AmirMohammad-Nouri/edge-ai-stress-sense/tools/ml/models/benchmark.md

# LOSO benchmark on WESAD wrist (BVP + EDA + ACC, no TEMP)

Accuracy / macro-F1 in %, leave-one-subject-out over 15 subjects.

## binary - raw features

| features | DT acc | DT F1 | RF acc | RF F1 | AB acc | AB F1 | LDA acc | LDA F1 | kNN acc | kNN F1 |
|---|---|---|---|---|---|---|---|---|---|---|
| bvp | 85.5 | 83.6 | 88.4 | 86.9 | 88.0 | 86.4 | 90.2 | 88.4 | 88.9 | 87.1 |
| eda | 78.8 | 75.0 | 80.5 | 77.1 | 78.6 | 75.1 | 85.4 | 82.4 | 84.7 | 82.3 |
| acc | 83.6 | 80.9 | 87.5 | 85.0 | 87.1 | 84.8 | 80.6 | 72.1 | 79.1 | 75.1 |
| physio | 84.0 | 82.1 | 86.5 | 85.0 | 87.6 | 85.9 | 91.2 | 89.6 | 90.1 | 88.6 |
| all | 85.9 | 84.4 | 86.8 | 85.3 | 90.2 | 88.7 | 94.3 | 93.3 | 91.9 | 90.6 |

## binary - relative to personal baseline

| features | DT acc | DT F1 | RF acc | RF F1 | AB acc | AB F1 | LDA acc | LDA F1 | kNN acc | kNN F1 |
|---|---|---|---|---|---|---|---|---|---|---|
| bvp | 84.3 | 81.6 | 87.6 | 85.4 | 87.9 | 85.8 | 87.8 | 85.1 | 85.8 | 82.9 |
| eda | 79.0 | 76.0 | 86.2 | 83.5 | 82.2 | 79.1 | 88.9 | 86.1 | 83.9 | 81.0 |
| acc | 81.0 | 77.6 | 81.9 | 76.4 | 81.7 | 77.9 | 77.7 | 71.5 | 77.0 | 69.9 |
| physio | 90.4 | 89.0 | 93.6 | 92.7 | 94.7 | 93.8 | 91.3 | 89.3 | 93.1 | 91.7 |
| all | 91.8 | 90.6 | 93.3 | 92.4 | 94.9 | 94.1 | 94.4 | 93.2 | 93.9 | 92.6 |

## 3class - raw features

| features | DT acc | DT F1 | RF acc | RF F1 | AB acc | AB F1 | LDA acc | LDA F1 | kNN acc | kNN F1 |
|---|---|---|---|---|---|---|---|---|---|---|
| bvp | 62.0 | 54.5 | 68.6 | 56.9 | 67.1 | 58.1 | 74.8 | 56.7 | 69.3 | 58.1 |
| eda | 56.2 | 46.2 | 60.8 | 49.5 | 59.2 | 49.9 | 70.3 | 50.9 | 66.7 | 56.6 |
| acc | 65.1 | 57.7 | 74.9 | 67.0 | 71.8 | 65.6 | 67.8 | 53.8 | 64.0 | 55.3 |
| physio | 59.5 | 54.1 | 67.1 | 57.0 | 63.8 | 58.3 | 74.6 | 57.3 | 69.5 | 59.1 |
| all | 69.1 | 64.0 | 72.3 | 65.0 | 70.4 | 65.2 | 77.3 | 66.7 | 74.7 | 65.9 |

## 3class - relative to personal baseline

| features | DT acc | DT F1 | RF acc | RF F1 | AB acc | AB F1 | LDA acc | LDA F1 | kNN acc | kNN F1 |
|---|---|---|---|---|---|---|---|---|---|---|
| bvp | 63.0 | 55.7 | 71.0 | 58.9 | 66.0 | 56.7 | 73.0 | 54.0 | 69.4 | 56.3 |
| eda | 62.1 | 53.0 | 74.0 | 62.4 | 69.3 | 57.8 | 72.5 | 53.9 | 66.6 | 56.4 |
| acc | 57.6 | 49.9 | 66.4 | 53.4 | 65.2 | 57.7 | 64.6 | 53.0 | 58.7 | 49.6 |
| physio | 69.0 | 61.5 | 77.5 | 64.2 | 74.8 | 65.4 | 75.5 | 58.3 | 75.3 | 62.0 |
| all | 71.5 | 63.9 | 77.3 | 63.2 | 76.1 | 69.9 | 77.6 | 66.9 | 76.7 | 65.5 |

Paper reference (wrist physio = BVP+EDA+TEMP, Table 3/4): binary RF 88.3 % acc / 86.1 % F1; 3-class AB 73.6 % / RF 76.2 % acc.
