AmirMohammad-Nouri/edge-ai-stress-sense/esp8266_vitals/src/secrets.example.h

#pragma once
// Normally generated from .env by `python3 tools/make_secrets.py`.
// Alternative: copy this file to esp8266_vitals/src/secrets.h and edit it by hand.
// esp8266_vitals/src/secrets.h is gitignored - never commit it.
#define WIFI_SSID      "your-wifi-name"
#define WIFI_PASSWORD  "your-wifi-password"
