AmirMohammad-Nouri/edge-ai-stress-sense/(commit log)

2026-11-06 Add wireless stress measurement system (ESP32 + ESP8266 + WESAD model + dashboard)
    - ESP8266 vitals node: PPG + Grove GSR via ADS1115 at 64 Hz, collect LED,
    broadcast heartbeats, START/ACK/STOP over UDP
    - ESP32: MPU6050 at 32 Hz and a coordinator that relays measurement commands
    to the ESP8266 over WiFi and reports device status to the laptop
    - Laptop server: voice intents ("measure my stress level", "calibrate my
    baseline", "stop"), UDP device hub with packet-loss stats, measurement
    orchestration with direct-to-ESP8266 fallback, session storage
    - ML: safe WESAD wrist extractor, shared feature extraction (BVP/EDA/ACC),
    LOSO benchmark/training script following Schmidt et al. 2018
    -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
2026-11-06 Add hardware setup and Arduino IDE step-by-step guide
    - README: parts list, wiring tables, sensor placement, bring-up checklist
    with expected serial output, hardware troubleshooting
    - STEP_BY_STEP.md: full build guide for the Arduino IDE (board packages,
    libraries, flashing, checks, training, use, experiment protocol)
    - Switch Quick start from PlatformIO to Arduino IDE (PlatformIO still noted)
2026-11-07 Move MPU6050 SCL from GPIO22 to GPIO32
    GPIO34/35 were requested but are input-only (no output driver, no
    pull-ups), so they cannot drive I2C SCL. GPIO32 is the nearest
    output-capable pin on the same header. Docs updated to match.
2026-11-07 Move WiFi credentials and laptop IP out of the code into .env
    - .env (gitignored) is the single place for WIFI_SSID, WIFI_PASSWORD,
    LAPTOP_IP; .env.example is the committed template
    - tools/make_secrets.py generates src/secrets.h and
    esp8266_vitals/src/secrets.h (both gitignored) for the Arduino builds
    - config.h includes secrets.h and fails with a clear #error if missing
    - Docs updated for the new setup step
    [config.h, secrets.example.h]
2026-11-07 Deploy pulse + skin model and rewrite README
    - train.py records the deployed feature set; progress output during the benchmark
    - Dashboard badge shows which sensors the model uses
    - Deploy the physio (PPG + GSR) models: motion alone predicts the WESAD
    stress condition (87.5%) because participants moved during the TSST speech,
    while physio-only scores the same as all sensors (94.7% vs 94.9%)
    - README rewritten: overview, architecture, hardware, setup, usage, ML method
    and results, wireless protocol, structure, troubleshooting, limitations
    - ESP32 voice pipeline reference moved to docs/VOICE_PIPELINE.md
2026-11-07 Add project website, dashboard screenshot and trained model
    - docs/: GitHub Pages site (index.html + assets) explaining architecture,
    hardware, firmware, wireless protocol, voice, ML method and results,
    with diagrams and charts from the benchmark
    - docs/images/dashboard.png: dashboard screenshot used by README and site
    - tools/ml/models/: deployed pulse + skin model and LOSO benchmark results
    - README links the website and notes the included model's WESAD terms
2026-11-07 Add realistic wiring illustrations for both boards
    - docs/images/wiring_esp32.svg and wiring_esp8266.svg: breadboard-style
    drawings of the boards, sensor modules and jumper wires, generated from the
    real pin orders by docs/images/draw_wiring.py
    - README: illustrations replace the text wiring diagram
    - Website: illustrations with captions in the Hardware section
    [draw_wiring.py]
